doubleZ-dev/codex-keyboard/hardware/README.md

# 硬件资料

- [嘉立创 EDA 专业版工程](ProPrj_Codex_key_2026-10-20_10-08-15_2026-11-04.epro)
- [当前 BOM v0.96](Codex_Keyboard_开源BOM_v0.96.xlsx)：采购和最新材料参考成本以此为准。
- [早期成本表](Codex_Micro_整机成本_含3D打印件_2026-10-29.xlsx)：保留历史资料。

配套说明：[硬件与 GPIO](../docs/hardware.md) · [成本与采购](../docs/cost.md) · [图文装配](../docs/assembly.md)。

作者于 2026-11-02 确认黑色键帽 ¥0.60 是整套价格，BOM 中数量 1 按一套理解。原表中单颗表述的更正见[成本说明](../docs/cost.md)。

作者补充：主控板两层，厚度约 1.6 mm 待核对订单；灯板四层、1.6 mm。表面处理等制造信息尚待补充，采购、打样前请核对工程、BOM、固件接口与下单记录。
