doubleZ-dev/codex-keyboard/docs/images/front.jpg

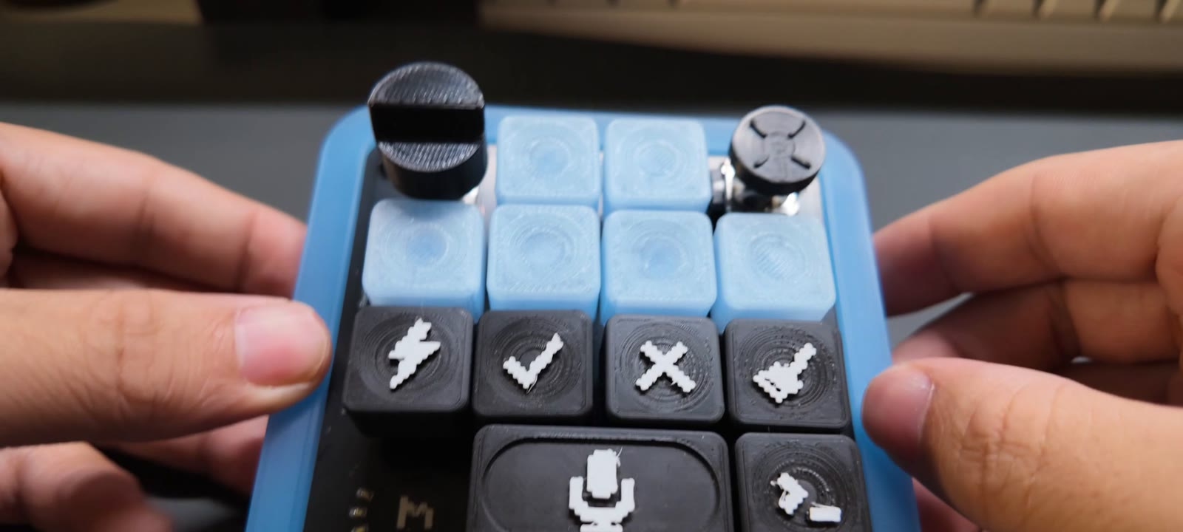
docs/images/front.jpg
