doubleZ-dev/codex-keyboard/hardware/Codex_Keyboard_开源BOM_v0.96.xlsx

Sheet: 成本总览
Codex Keyboard | 单机硬件成本
基于两份原始 BOM + 立创报价单 + 用户采购/3D 打印记录；价格以人民币计
成本分类 | 元件/装配单机成本 (¥) | 占总成本比例 | 来源 | 数量 / 时间
主控板元件 | ¥22.23 | 20.3% | 主控板原BOM | 29 类 / 48 件
灯板元件 | ¥45.60 | 41.7% | 灯板原BOM | 10 类 / 69 件
PCB | ¥21.00 | 19.2% | 电子器件合计 | 39 类 / 117 件
配套辅料 | ¥14.12 | 12.9% | 两份立创报价 | 2026-10-29
3D打印件 | ¥6.41 | 5.9% | 使用成本口径 | 单机实际装机
 |  |  | 价格更新 | 2026-11-01（采购规格更新）
整机材料成本 | ¥109.35 | 100.0% | 当前版本 | V0.96（电池容量850mAh）
统计口径：每台实际用量 × 采用单价；不按 MOQ/整包采购支出分摊，也不分摊立创整单折扣。
ESP32-S3 单价已由立创报价 ¥32.69 覆盖为用户淘宝实购价 ¥14.20；其他 38 种电子料沿用立创报价。
成本不包含：运费、焊接人工、贴片加工、设备折旧、试错损耗；如有其他未列配件需继续补充。
从“完整BOM”按板块筛选主控、灯板、PCB、辅料与打印件；绿色列是采用单价，蓝色列是行成本。

Sheet: 完整BOM
Codex Keyboard | Open-source Bill of Materials
V0.9 · 2026-11-01 · 单台实际用量核算 · 立创报价 2026-10-29 · ESP32-S3 采用淘宝实购价 ¥14.20
板块 | 物料分类 | 设计功能 | 原BOM序号 | 器件名称/Comment | 设计位号 | 每台数量 | BOM封装/Footprint | BOM数值/Value | 制造商型号/MPN | 制造商 | 立创物料编号 | 供应商 | 报价匹配状态 | 报价商品名称 | 报价匹配型号 | 报价品牌 | 报价封装 | 报价详细规格 | 商品链接 | 立创报价单价(¥) | 采用单价(¥) | 单机材料成本(¥) | MOQ | MPQ | 报价采购数量 | 报价采购小计(¥) | 供货渠道 | 交期 | 报价库存 | 价格来源 | 开源装配备注 | 资料状态 | 报价日期 | 原始报价文件 | 规格书链接 | 兼容替代型号
主控板元件 | 无源/电容 | 去耦、滤波或电源储能 | 1 | 100nF | C1,C2 | 2 | C0603 | 100nF | CC0603KRX7R9BB104 | YAGEO(国巨) | C14663 | LCSC | 系统匹配 | 100nF ±10% 50V | CC0603KRX7R9BB104 | YAGEO(国巨) | 0603 | 容值：100nF 精度：±10% 额定电压：50V 温度系数：X7R | https://item.szlcsc.com/15331.html | ¥0.0490 | ¥0.0490 | ¥0.0980 | 50 | 4000 | 50 | ¥2.45 | 现货 | 4小时内发货 | 42100 | 立创报价 2026-10-29 |  | 价格与型号齐全 | 2026-10-29 | 主控板立创报价.xls
主控板元件 | 无源/电容 | 去耦、滤波或电源储能 | 2 | 1uF | C7 | 1 | C0402 | 1uF | CL05A105KA5NQNC | SAMSUNG(三星) | C52923 | LCSC | 系统匹配 | 1uF ±10% 25V | CL05A105KA5NQNC | SAMSUNG(三星) | 0402 | 容值：1uF 精度：±10% 额定电压：25V 温度系数：X5R | https://item.szlcsc.com/53938.html | ¥0.0387 | ¥0.0387 | ¥0.0387 | 100 | 10000 | 100 | ¥3.87 | 现货 | 4小时内发货 | 2655500 | 立创报价 2026-10-29 |  | 价格与型号齐全 | 2026-10-29 | 主控板立创报价.xls
主控板元件 | 无源/电容 | 去耦、滤波或电源储能 | 3 | 22uF | C12,C13,C21 | 3 | C0603 | 22uF | CL10A226MP8NUNE | SAMSUNG(三星) | C86295 | LCSC | 系统匹配 | 22uF ±20% 10V | CL10A226MP8NUNE | SAMSUNG(三星) | 0603 | 容值：22uF 精度：±20% 额定电压：10V 温度系数：X5R | https://item.szlcsc.com/87471.html | ¥0.2004 | ¥0.2004 | ¥0.6012 | 10 | 3000 | 10 | ¥2.00 | 现货 | 4小时内发货 | 958720 | 立创报价 2026-10-29 |  | 价格与型号齐全 | 2026-10-29 | 主控板立创报价.xls
主控板元件 | 无源/电容 | 去耦、滤波或电源储能 | 4 | 100nF | C14,C15,C18,C19,C22,C25 | 6 | C0603 | 100nF | CL10B104KB8NNNC | SAMSUNG(三星) | C1591 | LCSC | 系统匹配 | 100nF ±10% 50V | CL10B104KB8NNNC | SAMSUNG(三星) | 0603 | 容值：100nF 精度：±10% 额定电压：50V 温度系数：X7R | https://item.szlcsc.com/1943.html | ¥0.0467 | ¥0.0467 | ¥0.2802 | 100 | 4000 | 100 | ¥4.67 | 现货 | 4小时内发货 | 51800 | 立创报价 2026-10-29 |  | 价格与型号齐全 | 2026-10-29 | 主控板立创报价.xls
主控板元件 | 无源/电容 | 去耦、滤波或电源储能 | 5 | 4.7uF | C16 | 1 | C0603 | 4.7uF | CL10A475KO8NNNC | SAMSUNG(三星) | C19666 | LCSC | 系统匹配 | 4.7uF ±10% 16V | CL10A475KO8NNNC | SAMSUNG(三星) | 0603 | 容值：4.7uF 精度：±10% 额定电压：16V 温度系数：X5R | https://item.szlcsc.com/20375.html | ¥0.1033 | ¥0.1033 | ¥0.1033 | 10 | 4000 | 10 | ¥1.03 | 现货 | 4小时内发货 | 525090 | 立创报价 2026-10-29 |  | 价格与型号齐全 | 2026-10-29 | 主控板立创报价.xls
主控板元件 | 无源/电容 | 去耦、滤波或电源储能 | 6 | 10uF | C17,C20 | 2 | C0603 | 10uF | CL10A106KP8NNNC | SAMSUNG(三星) | C19702 | LCSC | 系统匹配 | 10uF ±10% 10V | CL10A106KP8NNNC | SAMSUNG(三星) | 0603 | 容值：10uF 精度：±10% 额定电压：10V 温度系数：X5R | https://item.szlcsc.com/20411.html | ¥0.1290 | ¥0.1290 | ¥0.2580 | 20 | 4000 | 20 | ¥2.58 | 现货 | 4小时内发货 | 3186760 | 立创报价 2026-10-29 |  | 价格与型号齐全 | 2026-10-29 | 主控板立创报价.xls
主控板元件 | 电池/连接器 | 电池 1.25mm 双针连接器 | 7 | HC-1.25-2PLT | CN3 | 1 | CONN-SMD_HC-1.25-2PLT | 48 | HC-1.25-2PLT | HCTL(华灿天禄) | C2845388 | LCSC | 系统匹配 | 1x2P 间距:1.25mm 立贴 系列:PicoBlade(MX 1.25) | HC-1.25-2PLT | HCTL(华灿天禄) | SMD,P=1.25mm | 插针结构：1x2P 间距：1.25mm 安装方式：立贴 参考系列：PicoBlade(MX 1.25) 总PIN数：2P 排数：1 每排PIN数：2 行距：- 额定电流：2A 触头材质：黄铜 触头镀层：锡 工作温度：-25℃~+85℃ 额定电压：250V 塑料材质：LCP 阻燃等级：UL94V-0 附加特征：辅助焊脚 颜色：- Z轴-板上高度：4.75mm X轴-板上底边长度(间距线)：7.3mm Y轴-板上底边宽度：4.2mm | https://item.szlcsc.com/3039069.html | ¥0.3795 | ¥0.3795 | ¥0.3795 | 10 | 1500 | 10 | ¥3.80 | 现货 | 4小时内发货 | 101710 | 立创报价 2026-10-29 |  | 价格与型号齐全 | 2026-10-29 | 主控板立创报价.xls
主控板元件 | 电源/二极管 | 电源整流/隔离用肖特基二极管 | 8 | SS34 | D1,D3 | 2 | SMA_L4.2-W2.7-LS5.0-RD | 48 | SS34 | JSMSEMI(杰盛微) | C2837271 | LCSC | 系统匹配 | 电压:40V 电流:3A | SS34 | JSMSEMI(杰盛微) | SMA(DO-214AC) | 二极管配置：1个独立式 正向压降(Vf)：550mV@3A 直流反向耐压(Vr)：40V 整流电流：3A 反向电流(Ir)：- 工作结温范围：-50℃~+125℃ 非重复峰值浪涌电流 (Ifsm)：100A 耗散功率(Pd)：- | https://item.szlcsc.com/3007843.html | ¥0.1543 | ¥0.1543 | ¥0.3086 | 20 | 2000 | 20 | ¥3.09 | 现货 | 4小时内发货 | 545920 | 立创报价 2026-10-29 |  | 价格与型号齐全 | 2026-10-29 | 主控板立创报价.xls
主控板元件 | USB/保护 | USB D+/D− ESD 保护 | 9 | H5VL10B | D2,D4 | 2 | SOD-882_L1.0-W0.6-BI | 48 | H5VL10B | R+O(宏嘉诚) | C7420372 | LCSC | 系统匹配 | 丝印 PB 双向ESD 5V截止 峰值浪涌电流：5A | H5VL10B | R+O(宏嘉诚) | DFN1006-2L | 极性：双向 反向工作电压(Vrwm)：5V 钳位电压：10V 峰值脉冲电流(Ipp)：5A 峰值脉冲功率(Ppp)：50W 击穿电压(VBR)：5.6V 反向漏电流(Ir)：100nA 通道数：单路 工作温度：-55℃~+125℃ 防护等级：IEC 61000-4-2；IEC 61000-4-5 类型：ESD Cj-结电容：15pF 丝印 PB | https://item.szlcsc.com/8397194.html | ¥0.0371 | ¥0.0371 | ¥0.0743 | 50 | 10000 | 50 | ¥1.86 | 现货 | 4小时内发货 | 5237750 | 立创报价 2026-10-29 |  | 价格与型号齐全 | 2026-10-29 | 主控板立创报价.xls
主控板元件 | 板间连接 | 双板 30Pin、0.5mm FPC/FFC 接口 | 10 | FPC-05F-30PH20 | FPC2 | 1 | FPC-SMD_30P-P0.50_XUNPU_FPC-05F-30PH20 | 48 | FPC-05F-30PH20 | XUNPU(讯普) | C2856808 | LCSC | 系统匹配 | 翻盖式 下接 P数:30P 间距:0.5mm | FPC-05F-30PH20 | XUNPU(讯普) | SMD,P=0.5mm,卧贴 | 锁定特性：翻盖式 触点类型：下接 触点数量：30P 间距：0.5mm 安装方式：卧贴 接入柔性电缆厚度：0.3mm 板上高度：2mm 触头材质：磷青铜 触头镀层：锡 工作温度：-25℃~+85℃ 额定电压：50V 额定电流：500mA | https://item.szlcsc.com/3056906.html | ¥0.8728 | ¥0.8728 | ¥0.8728 | 5 | 2000 | 5 | ¥4.36 | 现货 | 4小时内发货 | 49585 | 立创报价 2026-10-29 |  | 价格与型号齐全 | 2026-10-29 | 主控板立创报价.xls
主控板元件 | 无源/电感 | 开关电源储能 | 11 | 4.7uH | L1 | 1 | IND-SMD_L4.0-W4.0_LVS404018 | 4.7uH | PNR4020-4R7-M | JIERR(捷而瑞) | C55381750 | LCSC | 系统匹配 | 4.7uH±20% 2.5A | PNR4020-4R7-M | JIERR(捷而瑞) | SMD,4x4mm | 电感值：4.7uH 精度：±20% 额定电流：2A 饱和电流(Isat)：2.5A 直流电阻(DCR)：75mΩ 类型：磁胶屏蔽电感 | https://item.szlcsc.com/59339378.html | ¥0.3755 | ¥0.3755 | ¥0.3755 | 10 | 3000 | 10 | ¥3.76 | 现货 | 4小时内发货 | 6270 | 立创报价 2026-10-29 |  | 价格与型号齐全 | 2026-10-29 | 主控板立创报价.xls
主控板元件 | 电源/切换 | P沟道MOS电源切换/开关 | 12 | AO3401A | Q1,Q2 | 2 | SOT-23_L2.9-W1.3-P1.90-LS2.4-BR | 48 | AO3401A | UMW(友台半导体) | C347476 | LCSC | 系统匹配 | 1个P沟道 耐压:30V 电流:4.2A | AO3401A | UMW(友台半导体) | SOT-23 | 数量：1个P沟道 漏源电压(Vdss)：30V 连续漏极电流(Id)：4.2A 导通电阻(RDS(on))：50mΩ@10V 耗散功率(Pd)：1.4W 阈值电压(Vgs(th))：1.3V 栅极电荷量(Qg)：9.4nC@4.5V 输入电容(Ciss)：954pF 反向传输电容(Crss)：77pF 工作温度：-55℃~+150℃ 类型：P沟道 输出电容(Coss)：115pF | https://item.szlcsc.com/324136.html | ¥0.1941 | ¥0.1941 | ¥0.3882 | 20 | 3000 | 20 | ¥3.88 | 现货 | 4小时内发货 | 1089980 | 立创报价 2026-10-29 |  | 价格与型号齐全 | 2026-10-29 | 主控板立创报价.xls
主控板元件 | 无源/电阻 | 上拉、限流、分压或反馈 | 13 | 10kΩ | R1,R2 | 2 | R0402 | 10kΩ | 0402WGF1002TCE | UNI-ROYAL(厚声) | C25744 | LCSC | 系统匹配 | 厚膜电阻 10kΩ ±1% 62.5mW | 0402WGF1002TCE | UNI-ROYAL(厚声) | 0402 | 电阻类型：厚膜电阻 阻值：10kΩ 精度：±1% 功率：62.5mW 工作电压：50V 温度系数：±100ppm/℃ 工作温度：-55℃~+155℃ | https://item.szlcsc.com/26487.html | ¥0.0142 | ¥0.0142 | ¥0.0284 | 100 | 10000 | 100 | ¥1.42 | 订货 | 预估7-10个工作日 | 0 | 立创报价 2026-10-29 |  | 价格与型号齐全 | 2026-10-29 | 主控板立创报价.xls
主控板元件 | 无源/电阻 | 上拉、限流、分压或反馈 | 14 | 510Ω | R3 | 1 | R0402 | 510Ω | FRC0402F5100TS | FOJAN(富捷) | C2909366 | LCSC | 系统匹配 | 厚膜电阻 510Ω ±1% 62.5mW | FRC0402F5100TS | FOJAN(富捷) | 0402 | 电阻类型：厚膜电阻 阻值：510Ω 精度：±1% 功率：62.5mW 工作电压：50V 温度系数：±100ppm/℃ 工作温度：-55℃~+155℃ | https://item.szlcsc.com/3186301.html | ¥0.0091 | ¥0.0091 | ¥0.0091 | 100 | 10000 | 100 | ¥0.91 | 现货 | 4小时内发货 | 2088400 | 立创报价 2026-10-29 |  | 价格与型号齐全 | 2026-10-29 | 主控板立创报价.xls
主控板元件 | 无源/电阻 | 上拉、限流、分压或反馈 | 15 | 22Ω | R4,R8 | 2 | R0402 | 22Ω | FRC0402F22R0TS | FOJAN(富捷) | C2929994 | LCSC | 系统匹配 | 厚膜电阻 22Ω ±1% 62.5mW | FRC0402F22R0TS | FOJAN(富捷) | 0402 | 电阻类型：厚膜电阻 阻值：22Ω 精度：±1% 功率：62.5mW 工作电压：50V 温度系数：±100ppm/℃ 工作温度：-55℃~+155℃ | https://item.szlcsc.com/3266927.html | ¥0.0095 | ¥0.0095 | ¥0.0190 | 100 | 10000 | 100 | ¥0.95 | 现货 | 4小时内发货 | 3976000 | 立创报价 2026-10-29 |  | 价格与型号齐全 | 2026-10-29 | 主控板立创报价.xls
主控板元件 | 无源/电阻 | 上拉、限流、分压或反馈 | 16 | 110kΩ | R5 | 1 | R0603 | 110kΩ | FRC0603F1103TS | FOJAN(富捷) | C2906984 | LCSC | 系统匹配 | 厚膜电阻 110kΩ ±1% 100mW | FRC0603F1103TS | FOJAN(富捷) | 0603 | 电阻类型：厚膜电阻 阻值：110kΩ 精度：±1% 功率：100mW 工作电压：75V 温度系数：±100ppm/℃ 工作温度：-55℃~+155℃ | https://item.szlcsc.com/3180497.html | ¥0.0113 | ¥0.0113 | ¥0.0113 | 100 | 5000 | 100 | ¥1.13 | 现货 | 4小时内发货 | 223400 | 立创报价 2026-10-29 |  | 价格与型号齐全 | 2026-10-29 | 主控板立创报价.xls
主控板元件 | 无源/电阻 | 上拉、限流、分压或反馈 | 17 | 15kΩ | R7 | 1 | R0603 | 15kΩ | FRC0603F1502TS | FOJAN(富捷) | C2906995 | LCSC | 系统匹配 | 厚膜电阻 15kΩ ±1% 100mW | FRC0603F1502TS | FOJAN(富捷) | 0603 | 电阻类型：厚膜电阻 阻值：15kΩ 精度：±1% 功率：100mW 工作电压：75V 温度系数：±100ppm/℃ 工作温度：-55℃~+155℃ | https://item.szlcsc.com/3180508.html | ¥0.0114 | ¥0.0114 | ¥0.0114 | 100 | 5000 | 100 | ¥1.14 | 现货 | 4小时内发货 | 4299300 | 立创报价 2026-10-29 |  | 价格与型号齐全 | 2026-10-29 | 主控板立创报价.xls
主控板元件 | 无源/电阻 | 上拉、限流、分压或反馈 | 18 | 5.1kΩ | R10,R11 | 2 | R0603 | 5.1kΩ | 0603WAF5101T5E | UNI-ROYAL(厚声) | C23186 | LCSC | 系统匹配 | 厚膜电阻 5.1kΩ ±1% 100mW | 0603WAF5101T5E | UNI-ROYAL(厚声) | 0603 | 电阻类型：厚膜电阻 阻值：5.1kΩ 精度：±1% 功率：100mW 工作电压：75V 温度系数：±100ppm/℃ 工作温度：-55℃~+155℃ | https://item.szlcsc.com/23913.html | ¥0.0091 | ¥0.0091 | ¥0.0182 | 100 | 5000 | 100 | ¥0.91 | 现货 | 4小时内发货 | 16407800 | 立创报价 2026-10-29 |  | 价格与型号齐全 | 2026-10-29 | 主控板立创报价.xls
主控板元件 | 无源/电阻 | 上拉、限流、分压或反馈 | 19 | 10kΩ | R13,R14 | 2 | R0603 | 10kΩ | FRC0603J103 TS | FOJAN(富捷) | C2930027 | LCSC | 系统匹配 | 厚膜电阻 10kΩ ±5% 100mW | FRC0603J103 TS | FOJAN(富捷) | 0603 | 电阻类型：厚膜电阻 阻值：10kΩ 精度：±5% 功率：100mW 工作电压：75V 温度系数：±100ppm/℃ 工作温度：-55℃~+155℃ | https://item.szlcsc.com/3266960.html | ¥0.0100 | ¥0.0100 | ¥0.0199 | 100 | 5000 | 100 | ¥1.00 | 现货 | 4小时内发货 | 6377900 | 立创报价 2026-10-29 |  | 价格与型号齐全 | 2026-10-29 | 主控板立创报价.xls
主控板元件 | 无源/电阻 | 上拉、限流、分压或反馈 | 20 | 100kΩ | R20,R23 | 2 | R0603 | 100kΩ | FRC0603J104 TS | FOJAN(富捷) | C2907088 | LCSC | 系统匹配 | 厚膜电阻 100kΩ ±5% 100mW | FRC0603J104 TS | FOJAN(富捷) | 0603 | 电阻类型：厚膜电阻 阻值：100kΩ 精度：±5% 功率：100mW 工作电压：75V 温度系数：±100ppm/℃ 工作温度：-55℃~+155℃ | https://item.szlcsc.com/3180601.html | ¥0.0064 | ¥0.0064 | ¥0.0127 | 100 | 5000 | 100 | ¥0.64 | 现货 | 4小时内发货 | 5341700 | 立创报价 2026-10-29 |  | 价格与型号齐全 | 2026-10-29 | 主控板立创报价.xls
主控板元件 | 无源/电阻 | 上拉、限流、分压或反馈 | 21 | 2kΩ | R25 | 1 | R0603 | 2kΩ | FRC0603J202 TS | FOJAN(富捷) | C2907137 | LCSC | 系统匹配 | 厚膜电阻 2kΩ ±5% 100mW | FRC0603J202 TS | FOJAN(富捷) | 0603 | 电阻类型：厚膜电阻 阻值：2kΩ 精度：±5% 功率：100mW 工作电压：75V 温度系数：±100ppm/℃ 工作温度：-55℃~+155℃ | https://item.szlcsc.com/3180650.html | ¥0.0076 | ¥0.0076 | ¥0.0076 | 100 | 5000 | 100 | ¥0.76 | 现货 | 4小时内发货 | 3773800 | 立创报价 2026-10-29 |  | 价格与型号齐全 | 2026-10-29 | 主控板立创报价.xls
主控板元件 | 电源/开关 | 侧拨电源滑动开关 | 22 | SS-205-AGS7P-150 | SW1 | 1 | SW-SMD_SS-205-AGS7P-150 | 48 | SS-205-AGS7P-150 | XUNPU(讯普) | C42377849 | LCSC | 系统匹配 | 卧式侧拨迷你七脚 贴片滑动开关 二档微型拨动开关 柄高1.5mm | SS-205-AGS7P-150 | XUNPU(讯普) | SMD-7P,5x1.4mm | 电路结构：单刀双掷 滑钮形状：矩形柱状 引脚样式：SMD接片 开关长度：5mm 开关宽度：1.4mm 开关高度：4.25mm 安装方式：卧贴 开关颜色：黑色 额定电流：50mA 额定电压：12V 工作寿命：1万次 操作力：150gf 触头镀层：银 行程长度：1.2mm 工作温度：-30℃~+85℃ | https://item.szlcsc.com/44278016.html | ¥0.7303 | ¥0.7303 | ¥0.7303 | 5 | 4000 | 5 | ¥3.65 | 现货 | 4小时内发货 | 4910 | 立创报价 2026-10-29 |  | 价格与型号齐全 | 2026-10-29 | 主控板立创报价.xls
主控板元件 | 控制/按键 | BOOT/RESET 功能按键 | 23 | ZX-QC34-2TPDZ | SW2,SW3 | 2 | KEY-SMD_L3.9-W3.0-LS5.0-EH | 48 | ZX-QC34-2TPDZ | Megastar(兆星) | C7470219 | LCSC | 系统匹配 | 3*4*2贴片开关带柱 | ZX-QC34-2TPDZ | Megastar(兆星) | SMD,4x3mm | 电路结构：单刀单掷 按钮形状：圆形按钮 作用力：2.6N 安装方式：立贴 开关长度：3mm 开关宽度：4mm 开关高度：2mm 带支架：不带支架 触点电流：50mA 额定电压：12V 按钮/盖帽颜色：黑色 引脚样式：鸥翼型 工作寿命：10万次 工作温度：-30℃~+80℃ | https://item.szlcsc.com/8519225.html | ¥0.2023 | ¥0.2023 | ¥0.4045 | 10 | 3000 | 10 | ¥2.02 | 现货 | 4小时内发货 | 24490 | 立创报价 2026-10-29 |  | 价格与型号齐全 | 2026-10-29 | 主控板立创报价.xls
主控板元件 | 数字逻辑 | 两条 RGB 数据链的 3.3V→5V 缓冲 | 24 | SN74AHCT1G125DBVR | U1,U2 | 2 | SOT-23-5_L3.0-W1.7-P0.95-LS2.8-BR | 48 | SN74AHCT1G125DBVR | TI(德州仪器) | C7484 | LCSC | 系统匹配 | 三态输出，单路总线缓冲门 | SN74AHCT1G125DBVR | TI(德州仪器) | SOT-23-5 | 输入类型：- 输出类型：三态 工作电压：4.5V~5.5V 元件数：1 每个元件位数：1 通道类型：单向 灌电流(IOL)：8mA 拉电流(IOH)：8mA 系列：74AHCT 工作温度：-40℃~+125℃ 静态电流(Iq)：10uA 传播延迟(tpd)：6.5ns@5V,15pF 功能特性：输出使能 | https://item.szlcsc.com/7961.html | ¥0.6131 | ¥0.6131 | ¥1.2262 | 5 | 3000 | 5 | ¥3.07 | 现货 | 4小时内发货 | 12540 | 立创报价 2026-10-29 |  | 价格与型号齐全 | 2026-10-29 | 主控板立创报价.xls
主控板元件 | 电源/升压 | 单节电池至 5V 升压 | 25 | MT3608B | U3 | 1 | SOT-23-6_L2.9-W1.6-P0.95-LS2.8-BR | 48 | MT3608B | 西安航天民芯 | C19189893 | LCSC | 系统匹配 | 升压型 4A 2.5V~24V 停产 | MT3608B | 西安航天民芯 | SOT-23-6 | 功能类型：升压型 工作电压：2.5V~24V 输出电压：- 输出电流：4A 开关频率：1.2MHz 工作温度：-40℃~+85℃ 同步整流：否 输出通道数：1 拓扑结构：升压式 静态电流(Iq)：70uA 开关管(内置/外置)：内置 输出类型：可调 功能特性：轻载高效模式；过流保护 | https://item.szlcsc.com/20421435.html | ¥0.6382 | ¥0.6382 | ¥0.6382 | 10 | 3000 | 10 | ¥6.38 | 现货 | 4小时内发货 | 85460 | 立创报价 2026-10-29 |  | 价格与型号齐全 | 2026-10-29 | 主控板立创报价.xls
主控板元件 | 电源/充电 | 单节锂电池 USB 充电 | 26 | TP4057 | U4 | 1 | SOT-23-6_L2.9-W1.6-P0.95-LS2.8-BL | 48 | TP4057 | TPOWER(天源) | C440390 | LCSC | 系统匹配 | 0.6A锂电池充电IC | TP4057 | TPOWER(天源) | SOT-23-6 | 芯片类型：充电芯片 工作电压：4.5V~5.5V 最大充电电流：600mA 充电饱和电压：4.2V 放电截止电压：- 电池类型：锂电池 电池节数：1 工作温度：-40℃~+85℃ 电池温度检测：不支持 0V电池充电：不支持 静态电流(Iq)：3uA 均衡电流：- 接口类型：- 功能特性：恒压充电；恒流充电；自动再充电；充电终止；软启动；可编程充电电流；欠压锁定；涓流充电 | https://item.szlcsc.com/439837.html | ¥0.4685 | ¥0.4685 | ¥0.4685 | 10 | 3000 | 10 | ¥4.69 | 现货 | 4小时内发货 | 4460 | 立创报价 2026-10-29 |  | 价格与型号齐全 | 2026-10-29 | 主控板立创报价.xls
主控板元件 | 电源/稳压 | 5V 降至 3.3V 供电 | 27 | AMS1117-3.3 | U5 | 1 | SOT-223-3_L6.7-W3.7-P2.30-LS7.0-BR | 48 | AMS1117-3.3 | GR(国睿) | C18164485 | LCSC | 系统匹配 | 3.3V 1A 15V | AMS1117-3.3 | GR(国睿) | SOT-223 | 输出极性：正极 工作电压：15V 输出电压：3.3V 输出电流：1A 电源纹波抑制比(PSRR)：75dB@(120Hz) 压差：1.2V@(1A) 静态电流(Iq)：5mA 噪声：0.003%Vout 功能特性：热关断；过流保护 工作温度：0℃~+150℃@(Tj) 输出类型：固定 输出通道数：1 | https://item.szlcsc.com/19305548.html | ¥0.2423 | ¥0.2423 | ¥0.2423 | 20 | 2500 | 20 | ¥4.85 | 现货 | 4小时内发货 | 36000 | 立创报价 2026-10-29 |  | 价格与型号齐全 | 2026-10-29 | 主控板立创报价.xls
主控板元件 | 主控/通信 | ESP32-S3 主控模组（USB HID/CDC、BLE、输入与灯光控制） | 28 | ESP32-S3-WROOM-1-N16R8 | U8 | 1 | WIRELM-SMD_ESP32-S3-WROOM-1 | 48 | ESP32-S3-WROOM-1-N16R8 | ESPRESSIF(乐鑫) | C2913202 | LCSC | 系统匹配 | 不带固件 通用型Wi-Fi+低功耗蓝牙MCU模组 | ESP32-S3-WROOM-1-N16R8 | ESPRESSIF(乐鑫) | SMD,25.5x18mm | 核心芯片：ESP32-S3R8 接口类型：I2C；GPIO；UART；SPI；USB；I2S 频率：2.4GHz 天线形式：板载PCB天线 发射功率：20.5dBm 工作电压：3V~3.6V 接收电流：95mA 发送电流：355mA 接收灵敏度：-103.5dBm 工作温度：-40℃~+65℃ 不带固件 | https://item.szlcsc.com/3198300.html | ¥32.6900 | ¥14.2000 | ¥14.2000 | 1 | 650 | 1 | ¥32.69 | 现货 | 4小时内发货 | 31338 | 淘宝实购 ¥14.20 | 以用户确认的实际单价覆盖立创报价 | 价格与型号齐全 | 2026-10-29 | 主控板立创报价.xls
主控板元件 | USB/连接器 | USB Type-C 数据与供电接口 | 29 | TYPE-C16PIN | USB1 | 1 | USB-C-SMD_TYPE-C16PIN | 48 | TYPE-C16PIN | SHOU HAN(首韩) | C393939 | LCSC | 系统匹配 | Type-C 母 卧贴 | TYPE-C16PIN | SHOU HAN(首韩) | SMD | 连接器类型：Type-C 协议标准：- 公母：母 安装方式：卧贴 触点数量：16P 端口数量：1 额定电流 - 电源：3A 额定电压：5V 插拔寿命：1万次 附加特征：- 中心高度(CH)：- 体长(L)：7.35mm 胶芯颜色：黑色 工作温度：-25℃~+85℃ | https://item.szlcsc.com/372551.html | ¥0.4007 | ¥0.4007 | ¥0.4007 | 10 | 1000 | 10 | ¥4.01 | 现货 | 4小时内发货 | 399000 | 立创报价 2026-10-29 |  | 价格与型号齐全 | 2026-10-29 | 主控板立创报价.xls
灯板元件 | 无源/电容 | 去耦、滤波或电源储能 | 1 | 100nF | C1,C2,C3,C4,C5,C6,C7,C8,C9,C10,C11,C12,C13 | 13 | C0603 | 100nF | CC0603KRX7R9BB104 | YAGEO(国巨) | C14663 | LCSC | 系统匹配 | 100nF ±10% 50V | CC0603KRX7R9BB104 | YAGEO(国巨) | 0603 | 容值：100nF 精度：±10% 额定电压：50V 温度系数：X7R | https://item.szlcsc.com/15331.html | ¥0.0490 | ¥0.0490 | ¥0.6370 | 50 | 4000 | 50 | ¥2.45 | 现货 | 4小时内发货 | 42100 | 立创报价 2026-10-29 |  | 价格与型号齐全 | 2026-10-29 | 灯板立创报价.xls
灯板元件 | 键盘/隔离二极管 | 矩阵逐键隔离、防鬼键 | 2 | 1N4148W-7-F | D1,D2,D3,D4,D5,D6,D7,D8,D9,D10,D11,D12,D13 | 13 | SOD-123_L2.7-W1.6-LS3.7-RD-1 | 22 | 1N4148W-7-F | DIODES(美台) | C83528 | LCSC | 系统匹配 | 100V 300mA | 1N4148W-7-F | DIODES(美台) | SOD-123 | 二极管配置：独立式 耗散功率(Pd)：400mW 整流电流：300mA 直流反向耐压(Vr)：100V 正向压降(Vf)：1.25V@150mA 非重复峰值浪涌电流 (Ifsm)：2A 反向电流(Ir)：1uA@75V 反向恢复时间(Trr)：4ns 工作结温范围：-65℃~+150℃ | https://item.szlcsc.com/84693.html | ¥0.1629 | ¥0.1629 | ¥2.1177 | 20 | 3000 | 20 | ¥3.26 | 现货 | 4小时内发货 | 5340 | 立创报价 2026-10-29 |  | 价格与型号齐全 | 2026-10-29 | 灯板立创报价.xls
灯板元件 | 板间连接 | 双板 30Pin、0.5mm FPC/FFC 接口 | 3 | FPC-05F-30PH20 | FPC2 | 1 | FPC-SMD_30P-P0.50_XUNPU_FPC-05F-30PH20 | 22 | FPC-05F-30PH20 | XUNPU(讯普) | C2856808 | LCSC | 系统匹配 | 翻盖式 下接 P数:30P 间距:0.5mm | FPC-05F-30PH20 | XUNPU(讯普) | SMD,P=0.5mm,卧贴 | 锁定特性：翻盖式 触点类型：下接 触点数量：30P 间距：0.5mm 安装方式：卧贴 接入柔性电缆厚度：0.3mm 板上高度：2mm 触头材质：磷青铜 触头镀层：锡 工作温度：-25℃~+85℃ 额定电压：50V 额定电流：500mA | https://item.szlcsc.com/3056906.html | ¥0.8728 | ¥0.8728 | ¥0.8728 | 5 | 2000 | 5 | ¥4.36 | 现货 | 4小时内发货 | 49585 | 立创报价 2026-10-29 |  | 价格与型号齐全 | 2026-10-29 | 灯板立创报价.xls
灯板元件 | 灯光/按键RGB | 13颗可寻址 RGB 按键背光 | 4 | SK6812MINI-E | LED1,LED2,LED3,LED4,LED5,LED6,LED7,LED8,LED9,LED10,LED11,LED12,LED13 | 13 | LED-SMD_4P-L3.2-W2.8-LS5.9_SK6812MINI-E | 22 | SK6812MINI-E | OPSCO(欧思科) | C5149201 | LCSC | 系统匹配 | 工作电压5V、发光角度120°、灰度调节256级的RGB LED | SK6812MINI-E | OPSCO(欧思科) | SMD | 主波长-红：620nm~625nm 主波长-绿：515nm~525nm 主波长-蓝：460nm~470nm 数据速率：800Kbit/s 工作电压：3.7V~5.5V 静态电流：0.6mA 透镜颜色：半透明透镜 抗静电能力：2000V 载带方式：- 工作温度：-40℃~+85℃ PWM频率：1kHz 灯头类型：- 发光角度：120° 长度：3.2mm 宽度：1.78mm 高度：2.8mm 脚间距：- 功能特性：- 峰值波长-红：- 峰值波长-绿：- 峰值波长-蓝：- 发光强度-红：160mcd~320mcd 发光强度-绿：815mcd~1275mcd 发光强度-蓝：120mcd~240mcd 传输延迟：- 上升时间：- 下降时间：- | https://item.szlcsc.com/5773397.html | ¥0.4923 | ¥0.4923 | ¥6.3999 | 5 | 2000 | 15 | ¥7.38 | 现货 | 4小时内发货 | 105325 | 立创报价 2026-10-29 |  | 价格与型号齐全 | 2026-10-29 | 灯板立创报价.xls
灯板元件 | 无源/电阻 | 上拉、限流、分压或反馈 | 5 | 1kΩ | R1,R2,R5 | 3 | R0402 | 1kΩ | 0402WGF1001TCE | UNI-ROYAL(厚声) | C11702 | LCSC | 系统匹配 | 厚膜电阻 1kΩ ±1% 62.5mW | 0402WGF1001TCE | UNI-ROYAL(厚声) | 0402 | 电阻类型：厚膜电阻 阻值：1kΩ 精度：±1% 功率：62.5mW 工作电压：50V 温度系数：±100ppm/℃ 工作温度：-55℃~+155℃ | https://item.szlcsc.com/12256.html | ¥0.0077 | ¥0.0077 | ¥0.0231 | 100 | 10000 | 100 | ¥0.77 | 现货 | 4小时内发货 | 11361900 | 立创报价 2026-10-29 |  | 价格与型号齐全 | 2026-10-29 | 灯板立创报价.xls
灯板元件 | 控制/编码器 | 旋转编码器及按压 | 6 | EC11E18244A5 | SW1 | 1 | SW-TH_EC11E18244A5 | 22 | EC11E18244A5 | ALPSALPINE(阿尔卑斯阿尔派) | C255515 | LCSC | 系统匹配 | 11mm尺寸金属轴类型 | EC11E18244A5 | ALPSALPINE(阿尔卑斯阿尔派) | 插件 | 编码器类型：增量式 节点数/脉冲数(增量式)：36/18 输出形式：两相输出 是否可下按：支持 转轴复位：自复位 安装方式：直插 额定电流：10mA 额定电压：5V 工作温度：-40℃~+85℃ | https://item.szlcsc.com/249470.html | ¥14.7800 | ¥14.7800 | ¥14.7800 | 1 | 120 | 1 | ¥14.78 | 现货 | 4小时内发货 | 262 | 立创报价 2026-10-29 |  | 价格与型号齐全 | 2026-10-29 | 灯板立创报价.xls
灯板元件 | 键盘/机械开关 | 13 键机械输入，4×4矩阵 | 7 | CPG151101D13 | U1,U4,U5,U7,U14,U15,U16,U17,U18,U19,U20,U21,U22 | 13 | KEY-TH_CPG151101D21X | 22 | CPG151101D13 | HanElectricity(瀚源) | C49234235 | LCSC | 系统匹配 | 青轴 | CPG151101D13 | HanElectricity(瀚源) | 插件 | 轴类型：青轴 作用力：50gf 触发行程：2.2mm 额定电压：12V 工作温度：-40℃~+70℃ | https://item.szlcsc.com/51650377.html | ¥0.6242 | ¥0.6242 | ¥8.1152 | 5 | 500 | 15 | ¥9.36 | 现货 | 4小时内发货 | 10130 | 立创报价 2026-10-29 |  | 价格与型号齐全 | 2026-10-29 | 灯板立创报价.xls
灯板元件 | 灯光/氛围RGB | 8颗可寻址 RGB 氛围灯 | 8 | WS2812B-4020-V6 | U2,U3,U6,U8,U9,U10,U11,U12 | 8 | LED-SMD_4P-L4.0-W1.7_DCS-CA4020A0R02G02B02CE004 | 22 | WS2812B-4020-V6 | worldsemi | C52941387 | LCSC | 系统匹配 | 智能外控集成LED光源，控制电路与RGB芯片集成，内置信号整形和复位电路，支持单线归零码通讯，光颜色高度一致 | WS2812B-4020-V6 | worldsemi | SMD-4P,4x2mm | 主波长-红：620nm~625nm 主波长-绿：515nm~525nm 主波长-蓝：465nm~475nm 数据速率：800Kbit/s 工作电压：3.3V~5.3V 静态电流：1uA 透镜颜色：- 抗静电能力：- 载带方式：- 工作温度：-40℃~+85℃ PWM频率：2kHz 灯头类型：- 发光角度：- 长度：3.98mm 宽度：2mm 高度：1.7mm 脚间距：- 功能特性：内置上电复位电路；集成智能反向连接保护功能；内置掉电复位电路 峰值波长-红：- 峰值波长-绿：- 峰值波长-蓝：- 发光强度-红：300mcd~500mcd 发光强度-绿：600mcd~1000mcd 发光强度-蓝：200mcd~300mcd 传输延迟：300ns 上升时间：- 下降时间：120us | https://item.szlcsc.com/55856750.html | ¥0.6416 | ¥0.6416 | ¥5.1328 | 5 | 2000 | 10 | ¥6.42 | 现货 | 4小时内发货 | 1090 | 立创报价 2026-10-29 |  | 价格与型号齐全 | 2026-10-29 | 灯板立创报价.xls
灯板元件 | 灯光/状态LED | 三颗图层/蓝牙状态指示灯 | 9 | XL-1005UWC | U13,U23,U24 | 3 | LED0402-RD_YELLOW | 22 | XL-1005UWC | XINGLIGHT(成兴光) | C20613596 | LCSC | 系统匹配 | 0402冷白光贴片式发光二极管 | XL-1005UWC | XINGLIGHT(成兴光) | 0402 | 灯头类型：1mmx0.5mm方形灯头 发光颜色：白色 正向压降(Vf)：2.8V 功率：75mW 测试电流：5mA 波长：- 峰值波长：- 二极管配置：独立二极管 透镜颜色：黄色透镜 色温：15000K 发光强度：1cd 发光角度：120° 载带方式：正贴 工作温度：-40℃~+85℃ 抗静电能力：2000V | https://item.szlcsc.com/21979587.html | ¥0.0657 | ¥0.0657 | ¥0.1972 | 50 | 5000 | 50 | ¥3.29 | 现货 | 4小时内发货 | 90050 | 立创报价 2026-10-29 |  | 价格与型号齐全 | 2026-10-29 | 灯板立创报价.xls
灯板元件 | 控制/摇杆 | 双轴模拟摇杆及按压 | 10 | 10kΩ | VR1 | 1 | SW-TH_RKJXV1224005 | 10kΩ | RKJXV122400R | ALPSALPINE(阿尔卑斯阿尔派) | C918854 | LCSC | 系统匹配 | 10kΩ ±5% | RKJXV122400R | ALPSALPINE(阿尔卑斯阿尔派) | 插件 | 阻值：10kΩ 精度：±5% 额定电压：5V 功率：125mW 圈数：- | https://item.szlcsc.com/995767.html | ¥7.3200 | ¥7.3200 | ¥7.3200 | 1 | 142 | 1 | ¥7.32 | 现货 | 4小时内发货 | 4794 | 立创报价 2026-10-29 |  | 价格与型号齐全 | 2026-10-29 | 灯板立创报价.xls
PCB | PCB/主控板 | 主控板裸板加工 |  | 主控板 PCB |  | 1 |  |  |  |  |  |  |  |  |  |  |  |  |  |  | ¥3.0000 | ¥3.0000 |  |  |  |  |  |  |  | 用户提供价格 | PCB 生产单价每片 ¥3；层数、厚度、表面处理可补 | 需补制造参数 | 2026-10-29 | 用户采购与打印记录
PCB | PCB/灯板 | 键盘灯板裸板加工 |  | 灯板 PCB |  | 1 |  |  |  |  |  |  |  |  |  |  |  |  |  |  | ¥18.0000 | ¥18.0000 |  |  |  |  |  |  |  | 用户提供价格 | PCB 生产单价每片 ¥18；层数、厚度、阻焊颜色可补 | 需补制造参数 | 2026-10-29 | 用户采购与打印记录
配套辅料 | 锂电池 | 单节锂电池供电 |  | 3.7V 850mAh 锂电池（订单选项 603443） |  | 1 |  | 3.7V / 850mAh / 603443 | 603443（商家选项） |  |  | 淘宝商家（订单截图） |  |  |  |  |  |  |  |  | ¥8.5000 | ¥8.5000 |  |  |  |  |  |  |  | 用户订单截图 + 已提供采购价格 | 3.7V 单节锂电池，额定容量 850mAh，订单选项 603443；保护板参数、线束极性仍按商家资料及实物核对。采购价 ¥8.50/个。 | 电压/容量/订单选项已补 | 2026-11-01 | 用户2026-11-01电池订单截图及容量补充
配套辅料 | 紧固件 | 热熔嵌入式固定 |  | M3 热熔螺母 M3×4×4.5 |  | 8 |  | M3×4×4.5mm | M3×4×4.5 |  |  | 淘宝商家（订单截图） |  |  |  |  |  |  |  |  | ¥0.0975 | ¥0.7800 | 40 |  | 40 | ¥3.90 |  |  |  | 用户订单截图 + 已提供采购价格 | 注塑热熔铜螺母；订单选项 M3×4×4.5，40只/包¥3.90；每台装8只。详细外形以商品尺寸图为准。 | 采购规格已补 | 2026-11-01 | 用户2026-11-01螺母订单截图
配套辅料 | 紧固件 | PCB/壳体装配 |  | M3×6 内六角圆柱头螺钉 |  | 8 |  | M3×6mm | M3×6 |  |  | 淘宝商家（订单截图） |  |  |  |  |  |  |  |  | ¥0.0520 | ¥0.4160 | 50 |  | 50 | ¥2.60 |  |  |  | 用户订单截图 + 已提供采购价格 | 商品描述：内六角圆柱头/杯头螺丝、12.9级高强度；订单 M3×6（50个）¥2.60；每台装8只。 | 采购规格已补 | 2026-11-01 | 用户2026-11-01螺丝订单截图
配套辅料 | 音频模块 | 数字麦克风输入 |  | INMP441 MEMS 数字麦克风模块 |  | 1 |  | I2S / MEMS | INMP441 模块（国产芯片版本） |  |  | 淘宝商家（订单截图） |  |  |  |  |  |  |  |  | ¥4.0000 | ¥4.0000 |  |  |  |  |  |  |  | 用户订单截图 + 已提供采购价格 | 订单选项：INMP441 模块（国产芯片）/不焊接；数字 I2S，连接 MIC_SCK、MIC_DIN、MIC_WS；价格¥4/个。 | 模块型号已补 | 2026-11-01 | 用户2026-11-01麦克风订单截图
配套辅料 | FFC排线 | 连接主控板与灯板的30针排线 |  | 30Pin 0.5mm 100mm 异面 FFC 排线 |  | 1 |  | 30P / P0.5 / L100mm / 反向 | 30P 反向 0.5mm间距 100mm |  |  | 淘宝商家（订单截图） |  |  |  |  |  |  |  |  | ¥0.4200 | ¥0.4200 | 5 |  | 5 | ¥2.10 |  |  |  | 淘宝订单实付¥2.10/5条，平均¥0.42/条 | 30P反向、0.5mm间距、长100mm；5条装共¥2.10，单机1条成本¥0.42。 | 采购规格已补 | 2026-11-01 | 用户2026-11-01 FFC订单截图
3D打印件 | 结构/支撑 | 承托和定位组件 |  | 3D打印支撑板 |  | 1 |  | 半透明 PLA | 自制打印件 / 半透明 PLA |  |  |  |  |  |  |  |  |  |  |  | ¥3.5000 | ¥3.5000 |  |  |  |  |  |  |  | 用户提供实际打印材料成本 | 支撑板：半透明 PLA；每台1件，成本¥3.50。 STL/STEP和打印参数由结构文件提供。 | 材料与价格已补 | 2026-11-01 | 用户采购与打印记录
3D打印件 | 结构/底座 | 外壳底部结构 |  | 3D打印底座 |  | 1 |  | 丝绸银 PLA | 自制打印件 / 丝绸银 PLA |  |  |  |  |  |  |  |  |  |  |  | ¥1.4100 | ¥1.4100 |  |  |  |  |  |  |  | 用户提供实际打印材料成本 | 底座：丝绸银 PLA；每台1件，成本¥1.41。 STL/STEP和打印参数由结构文件提供。 | 材料与价格已补 | 2026-11-01 | 用户采购与打印记录
3D打印件 | 键帽/透明 | 六颗半透明键帽 |  | 3D打印透明键帽 |  | 6 |  | 半透明 PLA | 自制打印件 / 半透明 PLA |  |  |  |  |  |  |  |  |  |  |  | ¥0.1167 | ¥0.7000 | 6 |  | 6 | ¥0.70 |  |  |  | 用户提供实际打印材料成本 | 六颗透明键帽均使用半透明 PLA；6件合计¥0.70。 STL/STEP和打印参数由结构文件提供。 | 材料与价格已补 | 2026-11-01 | 用户采购与打印记录
3D打印件 | 键帽/黑色 | 一颗黑色键帽 |  | 3D打印黑色键帽 |  | 1 |  | 黑色 PLA | 自制打印件 / 黑色 PLA |  |  |  |  |  |  |  |  |  |  |  | ¥0.6000 | ¥0.6000 |  |  |  |  |  |  |  | 用户提供实际打印材料成本 | 黑色键帽使用黑色 PLA；每台1件，成本¥0.60。 STL/STEP和打印参数由结构文件提供。 | 材料与价格已补 | 2026-11-01 | 用户采购与打印记录
3D打印件 | 小型打印附件 | 旋钮帽、摇杆帽、拨动开关操作帽 |  | 3D打印小配件三件套 |  | 1 |  | 黑色 PLA | 自制打印件 / 黑色 PLA |  |  |  |  |  |  |  |  |  |  |  | ¥0.2000 | ¥0.2000 | 1 |  | 1 | ¥0.20 |  |  |  | 用户提供实际打印材料成本 | 旋钮帽、摇杆帽、拨动开关帽均用黑色 PLA，3件合计¥0.20。 STL/STEP和打印参数由结构文件提供。 | 材料与价格已补 | 2026-11-01 | 用户采购与打印记录

Sheet: 待补采购资料
序号 | 部件 / 主题 | 需提供的实际参数 | 为什么用于开源复刻 | 已有信息
1 | 电池 | 保护板持续电流/规格、极性与插头；商品链接 | 确认电源适配及采购 | 已提供：3.7V、850mAh、订单选项603443，¥8.50/个
2 | 热熔螺母 | 外径/长度和孔配合数据，商品链接 | 确保3D孔位与压入深度一致 | 已提供：M3×4×4.5，40个¥3.90，装8个
3 | M3 螺钉 | 可附安装位置和购买链接 | 确认头部、沉孔与装配余量 | 已提供：M3×6 内六角圆柱头，商品描述12.9级，50个¥2.60，装8个
4 | 音频模块 | 模块引脚顺序、供电和外形尺寸；商品链接 | 复刻模块接线与软件定义一致 | 已提供：INMP441（国产芯片、不焊接），¥4/个
5 | FFC 排线 | 商品链接、线缆厚度及装配照片（可选） | 采购同规格排线 | 已提供：30P反向、0.5mm、100mm，5条¥2.10；单台¥0.42
6 | 3D 打印件 | STL/STEP文件与打印参数；材料和颜色已明确 | 第三方使用同材料与零件数量打印 | 半透明PLA：支撑板+6透明键；丝绸银PLA：底座；黑色PLA：黑色键+3小配件
7 | 主控板 PCB | 板层、厚度、阻焊颜色、表面处理、Gerber/EDA文件版本 | 方便第三方直接打样 | ¥3.00/片
8 | 灯板 PCB | 板层、厚度、阻焊颜色、表面处理、Gerber/EDA文件版本 | 方便第三方直接打样 | ¥18.00/片
9 | 附加装配物料 | 其他键帽、橡胶垫、双面胶、导光件、装饰件是否存在及数量价格 | 避免开源 BOM 遗漏实际使用物料 | 当前只记已报价格的项
10 | 零件规格书链接 | 核心 IC 与连接器若有官方 datasheet URL，可补填完整BOM的规格书链接列 | 制造/替代核查更方便 | BOM已提供立创商品链接和厂家型号

Sheet: 开源说明
Codex Keyboard | 开源 BOM 使用说明
BOM 版本 | v0.96 / 2026-11-01
设计名称 | Codex Keyboard — ESP32-S3 USB/BLE 自制复刻键盘
主控板BOM来源 | BOM_CpuBoard2_CpuSchematic1_2026-10-23.xlsx
灯板BOM来源 | BOM_KeyBoard1_KeyboardSchematic1_2026-10-29.xlsx
主控板报价来源 | Codex_key_…CpuSchematic1_20261029_143657-立创_20261029.xls
灯板报价来源 | Codex_key_…KeyboardSchematic1_20261029_143747-立创_20261029.xls
报价采集日期 | 2026-10-29；供应商报价是历史价格，随时间和起订量变化
ESP32 主控单价 | 用户提供的淘宝实际采购价 ¥14.20，替代立创报价 ¥32.69
成本核算规则 | 仅按单台实际消耗数量×采用单价核算；FFC按¥2.10/5条分摊¥0.42/条；整包采购额另列
报价说明 | 立创报价单部分页面含整单优惠与额外库存信息；未将折扣分摊到单颗价格
器件检索 | 2026-11-01：补充电池 603443 容量850mAh；保留M3×4×4.5热熔螺母、M3×6螺钉、INMP441、30P反向FFC及PLA材料规格
电子BOM位号 | 3D打印：支撑板/透明键帽=半透明PLA；底座=丝绸银PLA；黑色键帽/小配件=黑色PLA
费用范围 | 不包含运费、焊接加工、贴片服务费、工具/失败损耗、其他未列入物料
制造与版权 | 开源发布前确定硬件/结构/固件许可证；原始 BOM 中的制造商商标和第三方资料仍各归其所有
更新方式 | 后续填写“待补采购资料”，并同步更新“完整BOM”中空白字段；不要猜测具体尺寸或型号
