doubleZ-dev/codex-keyboard/hardware/Codex_Micro_整机成本_含3D打印件_2026-10-29.xlsx

Sheet: 单机成本汇总
项目 | 成本(¥) | 依据 | 说明
主控板元件 | ¥22.23 | 立创报价明细 | 按实际使用数量 × 单价
灯板元件 | ¥45.60 | 立创报价明细 | 按实际使用数量 × 单价
两块 PCB | ¥21.00 | 用户提供 | 主控 3 元 + 灯板 18 元
额外物料 | ¥14.20 | 用户提供 | 电池、螺母、螺钉、音频、FFC
整机单机成本 | ¥103.02 | 合计 | 不含外壳、键帽、运费、贴片及损耗
3D 打印结构件 | ¥6.41 | 用户提供 | 支撑板、底座、6颗透明键、黑键、三件小配件
更新后整机单机成本 | ¥109.43 | 按实际使用数量 | 不含尚未列入的其他零件、运费及人工
核算口径 | 这里只计算一台实际消耗的元件，不将整包采购价当作单台成本
注意 | 立创报价存在起订量；此处仅计单机用量
核算口径 | 透明按键 ¥0.70 视为六颗合计

Sheet: 主控板元件
器件名称 | 位号 | 单机使用数量 | 报价单单价(¥) | 采购数量(MOQ) | 报价单采购小计(¥) | 单机用量成本(¥)
ESP32-S3-WROOM-1-N16R8 | U8 | 1 | 14.2000 | 1.0000 | 32.6900 | 14.2000
22uF | C21,C13,C12 | 3 | 0.2004 | 10.0000 | 2.0000 | 0.6012
100nF | C22,C25,C15,C14,C18,C19 | 6 | 0.0467 | 100.0000 | 4.6700 | 0.2802
ZX-QC34-2TPDZ | SW2,SW3 | 2 | 0.2023 | 10.0000 | 2.0200 | 0.4045
100kΩ | R20,R23 | 2 | 0.0064 | 100.0000 | 0.6400 | 0.0127
10kΩ | R2,R1 | 2 | 0.0142 | 100.0000 | 1.4200 | 0.0284
1uF | C7 | 1 | 0.0387 | 100.0000 | 3.8700 | 0.0387
FPC-05F-30PH20 | FPC2 | 1 | 0.8728 | 5.0000 | 4.3600 | 0.8728
SN74AHCT1G125DBVR | U1,U2 | 2 | 0.6131 | 5.0000 | 3.0700 | 1.2262
100nF | C1,C2 | 2 | 0.0490 | 50.0000 | 2.4500 | 0.0980
510Ω | R3 | 1 | 0.0091 | 100.0000 | 0.9100 | 0.0091
MT3608B | U3 | 1 | 0.6382 | 10.0000 | 6.3800 | 0.6382
110kΩ | R5 | 1 | 0.0113 | 100.0000 | 1.1300 | 0.0113
15kΩ | R7 | 1 | 0.0114 | 100.0000 | 1.1400 | 0.0114
4.7uH | L1 | 1 | 0.3755 | 10.0000 | 3.7600 | 0.3755
SS34 | D1,D3 | 2 | 0.1543 | 20.0000 | 3.0900 | 0.3086
AO3401A | Q1,Q2 | 2 | 0.1941 | 20.0000 | 3.8800 | 0.3882
10kΩ | R14,R13 | 2 | 0.0100 | 100.0000 | 1.0000 | 0.0199
5.1kΩ | R11,R10 | 2 | 0.0091 | 100.0000 | 0.9100 | 0.0182
TYPE-C16PIN | USB1 | 1 | 0.4010 | 10.0000 | 4.0100 | 0.4010
报价行 27 | - | 1 | 0.1030 | 10.0000 | 1.0300 | 0.1030
报价行 28 | - | 1 | 0.4690 | 10.0000 | 4.6900 | 0.4690
报价行 29 | - | 2 | 0.1290 | 20.0000 | 2.5800 | 0.2580
报价行 30 | - | 1 | 0.2425 | 20.0000 | 4.8500 | 0.2425
报价行 31 | - | 1 | 0.7300 | 5.0000 | 3.6500 | 0.7300
报价行 32 | - | 1 | 0.0076 | 100.0000 | 0.7600 | 0.0076
报价行 33 | - | 1 | 0.3800 | 10.0000 | 3.8000 | 0.3800
报价行 34 | - | 2 | 0.0095 | 100.0000 | 0.9500 | 0.0190
报价行 35 | - | 2 | 0.0372 | 50.0000 | 1.8600 | 0.0744

Sheet: 灯板元件
器件名称 | 位号 | 单机使用数量 | 报价单单价(¥) | 采购数量(MOQ) | 报价单采购小计(¥) | 单机用量成本(¥)
CPG151101D13 | U1,U4,U5,U7,U14,U15,U16,U17,U18,U19,U20,U21,U22 | 13 | 0.6242 | 15.0000 | 9.3600 | 8.1152
1N4148W-7-F | D1,D2,D3,D4,D5,D6,D7,D8,D9,D10,D11,D12,D13 | 13 | 0.1629 | 20.0000 | 3.2600 | 2.1177
SK6812MINI-E | LED1,LED2,LED3,LED4,LED5,LED6,LED7,LED8,LED9,LED10,LED11,LED12,LED13 | 13 | 0.4923 | 15.0000 | 7.3800 | 6.3999
100nF | C1,C2,C3,C4,C5,C6,C7,C8,C9,C10,C11,C12,C13 | 13 | 0.0490 | 50.0000 | 2.4500 | 0.6370
WS2812B-4020-V6 | U2,U3,U6,U8,U9,U10,U11,U12 | 8 | 0.6416 | 10.0000 | 6.4200 | 5.1328
10kΩ | VR1 | 1 | 7.3200 | 1.0000 | 7.3200 | 7.3200
EC11E18244A5 | SW1 | 1 | 14.7800 | 1.0000 | 14.7800 | 14.7800
XL-1005UWC | U13,U23,U24 | 3 | 0.0657 | 50.0000 | 3.2900 | 0.1972
1kΩ | R1,R5,R2 | 3 | 0.0077 | 100.0000 | 0.7700 | 0.0231
FPC-05F-30PH20 | FPC2 | 1 | 0.8728 | 5.0000 | 4.3600 | 0.8728

Sheet: 其他物料
其他成本项目 | 实际数量 | 单价(¥) | 单机成本(¥)
锂电池 | 1 | ¥8.50 | ¥8.50
热熔螺母 | 8 | ¥0.10 | ¥0.78
M3 螺丝 | 8 | ¥0.05 | ¥0.42
音频模块 | 1 | ¥4.00 | ¥4.00
FFC 排线 | 1 | ¥0.50 | ¥0.50
主控板 PCB | 1 | ¥3.00 | ¥3.00
灯板 PCB | 1 | ¥18.00 | ¥18.00
3D打印支撑板 | 1 | ¥3.50 | ¥3.50
3D打印底座 | 1 | ¥1.41 | ¥1.41
透明按键（6颗合计） | 1 | ¥0.70 | ¥0.70
黑色按键 | 1 | ¥0.60 | ¥0.60
旋钮帽+摇杆帽+拨动开关打印件（合计） | 1 | ¥0.20 | ¥0.20
3D打印件小计 |  |  | ¥6.41
其他物料含3D打印件合计 |  |  | ¥41.61
