doubleZ-dev/codex-keyboard/3d-print/BambuStudio_六个打印盘/OPENKEY_六盘总工程_槽宽1.20正式版.3mf

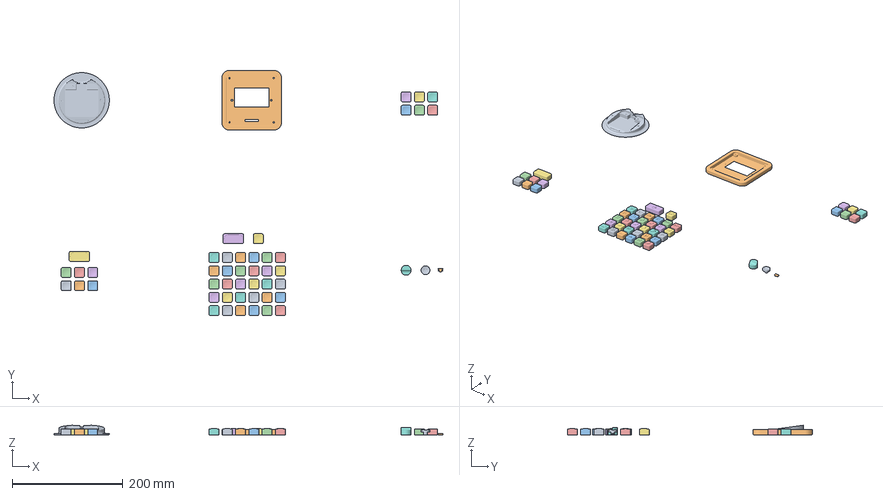
[picture p7: CAD file, 2026-10-30]
3d-print/BambuStudio_六个打印盘/OPENKEY_六盘总工程_槽宽1.20正式版.3mf
703.0 x 443.2 x 17.4 mm
底座
支撑板
透明键帽_1U x 6
纯黑键帽_1U x 6
纯黑键帽_长键
Pixel_01_agent
Pixel_02_ai-chip
Pixel_03_terminal
Pixel_04_download
Pixel_05_delete
Pixel_06_edit
Pixel_07_send
Pixel_08_spark
Pixel_09_new
Pixel_10_run
Pixel_11_history
Pixel_12_branch
Pixel_13_branch-plus
Pixel_14_sync
Pixel_15_clean
Pixel_16_experiment
Pixel_17_party
Pixel_18_clock
Pixel_19_think
Pixel_20_focus
Pixel_21_boost
Pixel_22_accept
Pixel_23_cancel
Pixel_24_split
Pixel_25_settings
Pixel_26_folder-plus
Pixel_27_upload
Pixel_28_apps
Pixel_29_yolo
Pixel_30_yeet
Pixel_31_voice-long
Pixel_32_chat-terminal
旋钮帽_编码器
摇杆帽
电源开关拨片
