doubleZ-dev/codex-keyboard/3d-print/BambuStudio_六个打印盘/03_六个透明键帽.3mf

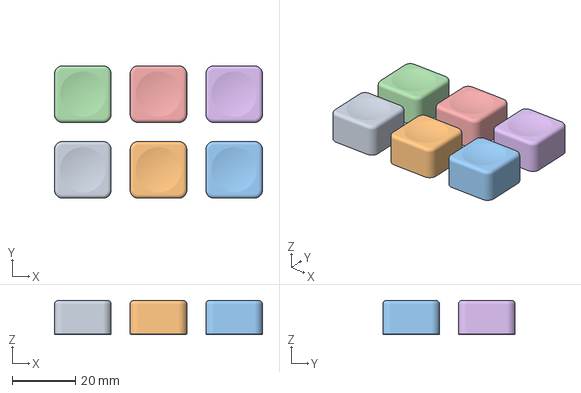
[picture p8: CAD file, 2026-10-30]
3d-print/BambuStudio_六个打印盘/03_六个透明键帽.3mf
66.0 x 42.0 x 10.8 mm
透明键帽_1U x 6
