doubleZ-dev/codex-keyboard/3d-print/BambuStudio_六个打印盘/01_底座.3mf

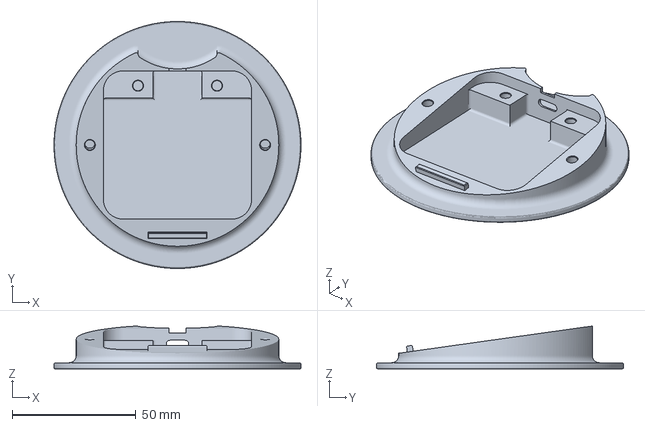
[picture p9: CAD file, 2026-10-30]
3d-print/BambuStudio_六个打印盘/01_底座.3mf
100.0 x 100.0 x 17.4 mm
