doubleZ-dev/codex-keyboard/3d-print/BambuStudio_六个打印盘/04_七个纯黑键帽.3mf

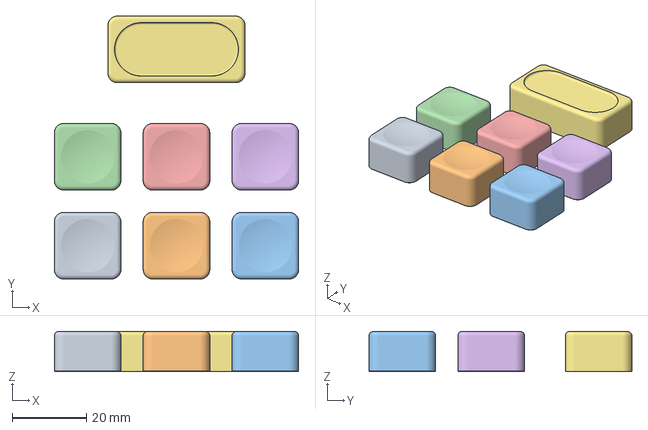
[picture p10: CAD file, 2026-10-30]
3d-print/BambuStudio_六个打印盘/04_七个纯黑键帽.3mf
66.0 x 71.0 x 10.8 mm
纯黑键帽_1U x 6
纯黑键帽_长键
