doubleZ-dev/codex-keyboard/3d-print/BambuStudio_六个打印盘/06_旋钮帽和摇杆帽.3mf

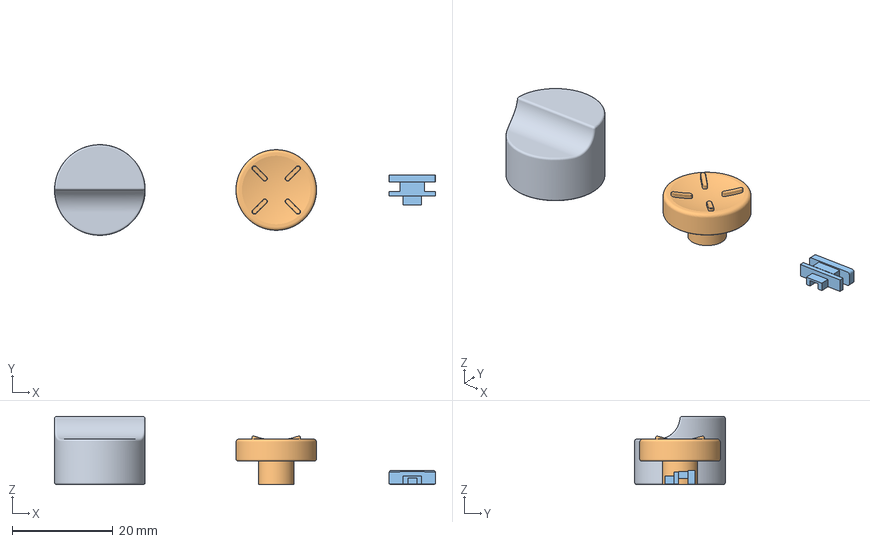
[picture p11: CAD file, 2026-10-30]
3d-print/BambuStudio_六个打印盘/06_旋钮帽和摇杆帽.3mf
75.6 x 18.0 x 13.5 mm
旋钮帽_编码器
摇杆帽
电源开关拨片
