doubleZ-dev/codex-keyboard/3d-print/BambuStudio_六个打印盘/02_支撑板.3mf

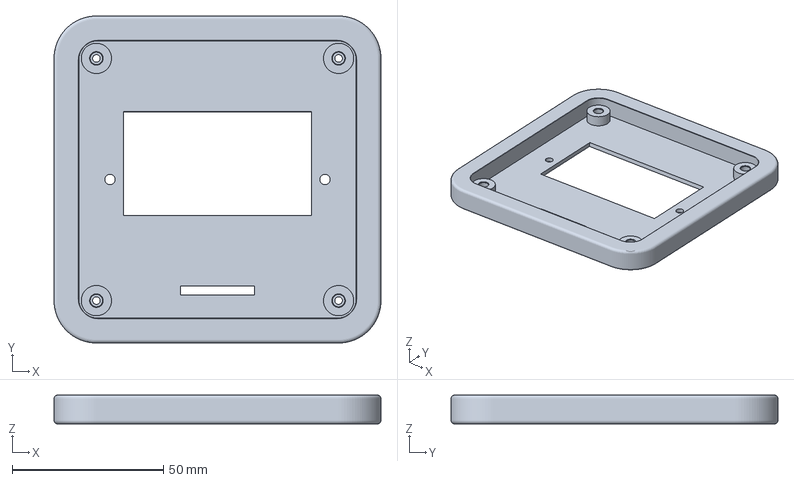
[picture p12: CAD file, 2026-10-30]
3d-print/BambuStudio_六个打印盘/02_支撑板.3mf
108.0 x 108.0 x 9.50 mm
