doubleZ-dev/codex-keyboard/docs/video-guide.md

# 视频导览与图片来源

[返回项目首页](../README.md) · [图文制作教程](assembly.md) · [使用说明](usage.md)

**[观看完整视频：我逆向复刻了 Codex 键盘，成本只要…（哔哩哔哩）](https://b23.tv/TivtklJ)**

本文档与配图来自作者提供的完整视频 `V2_final_2K.mp4`，约 **6 分 01 秒**，原始画面 **2560×1440 / 30 fps**，并结合对应文案与现有固件资料整理。原始大视频未提交到仓库。

## 章节索引

时间是原始成片中的大致位置。成片包含转场与插入画面，图文教程按实际制作顺序重新组织。

| 时间 | 内容 |
| --- | --- |
| 00:00 | 项目与成品介绍、成本、主要功能 |
| 00:36 | 硬件设计、原理图、PCB、焊接与电气检查 |
| 01:58 | 结构设计、材料、打印与图案键帽 |
| 03:05 | 热熔螺母、主控板、电池、支撑板与按键装配 |
| 03:41 | Agent 键、状态灯、语音、旋钮、摇杆与 Input |
| 04:55 | 项目创作过程与总结 |

## 已采用的截图

JPEG 图片从视频直接抽取，裁去底部章节条，多数同时裁去硬编码字幕区域，再缩放至 1600 像素宽。个别装配总览保留更高的画面以展示零件。未生成替代实物的合成画面。截图中的制作过程或旧结构不作为所有版本尺寸一致的证明。

| 时间 | 图片 | 用途 |
| --- | --- | --- |
| 03:53.0 | [成品主图](images/hero.jpg) | 成品主图 |
| 00:08.0 | [正面近景](images/front.jpg) | 正面近景 |
| 00:37.5 | [视频中的结构分解展示](images/exploded.jpg) | 视频中的结构分解展示 |
| 03:00.2 | [主要零件总览](images/parts.jpg) | 主要零件总览 |
| 01:21.7 | [主控板贴装](images/solder-power.jpg) | 主控板贴装 |
| 01:33.0 | [主控板元件面](images/mainboard.jpg) | 主控板元件面 |
| 01:43.4 | [按键/灯板](images/keyboard-pcb.jpg) | 按键/灯板 |
| 01:48.0 | [万用表检查](images/continuity.jpg) | 万用表检查 |
| 01:56.4 | [封壳前亮灯测试](images/first-light.jpg) | 封壳前亮灯测试 |
| 02:52.0 | [图案键帽](images/printed-keycaps.jpg) | 图案键帽 |
| 03:07.7 | [底座热熔螺母](images/heat-inserts.jpg) | 底座热熔螺母 |
| 03:17.0 | [支撑板热熔螺母](images/support-inserts.jpg) | 支撑板热熔螺母 |
| 03:21.5 | [主控板与电池](images/mainboard-battery.jpg) | 主控板与电池 |
| 03:25.2 | [支撑板固定](images/support-install.jpg) | 支撑板固定 |
| 03:28.0 | [安装按键板](images/keyboard-install.jpg) | 安装按键板 |
| 03:33.5 | [安装键帽](images/keycaps-install.jpg) | 安装键帽 |
| 03:38.0 | [装配成品](images/assembled.jpg) | 装配成品 |
| 04:09.3 | [灯光展示](images/agent-demo.jpg) | 灯光展示 |

`controls.svg` 为根据实物布局和当前固件说明绘制的功能示意；`cost-breakdown.svg` 根据 BOM v0.96 数据生成。两者是说明图，不是实物照片或制造图。

## 如何理解演示证据

视频展示的操作用于解释制作方法与使用流程。状态灯展示中包含人为演示，不能据颜色判断实际 Agent 任务状态。对于当前固件行为，以[使用说明的差异与限制](usage.md#当前版本的差异与限制)及包内版本记录为准。
