doubleZ-dev/codex-keyboard/CHANGELOG.md

# 更新记录

## 2026-11-02 · 项目文档完善

- 扩充项目首页，加入成品、主要功能、硬件组成、成本表、制作路径和下载导航。
- 从作者提供的视频提取 18 张实物/结构/装配画面，加入时间索引。
- 增加控件示意图、成本图，以及打印、硬件、制作、刷写、使用和开发说明。
- 加入原始 BOM v0.96，当前已列物料参考合计 ¥109.35，黑色键帽按作者确认的整套价格解释。
- 加入作者 B 站视频链接、主控板两层与灯板四层的打样信息。
- 核对五个总工程文件为相同内容，明确一个推荐入口。
- 固件仍为 1.0.0-rc.7，本次文档更新没有执行设备烧录或新增实机验收。
