doubleZ-dev/codex-keyboard/(list of files, drawings)

Other design files:
hardware/ProPrj_Codex_key_2026-10-20_10-08-15_2026-11-04.epro
