doubleZ-dev/codex-keyboard/(commit log)

2026-10-30 Add Codex Keyboard hardware, print files, and current firmware
    [01_底座.3mf, 02_支撑板.3mf, 03_六个透明键帽.3mf, 04_七个纯黑键帽.3mf, 05_三十二个图案键帽.3mf, 06_旋钮帽和摇杆帽.3mf, Codex_Micro_整机成本_含3D打印件_2026-10-29.xlsx, OPENKEY_六盘总工程.3mf]
2026-11-02 Expand project guides with build video frames and BOM v0.96
    [Codex_Keyboard_开源BOM_v0.96.xlsx]
2026-11-04 Update hardware archive to 2026-11-04
    [ProPrj_Codex_key_2026-10-20_10-08-15_2026-10-22.epro, ProPrj_Codex_key_2026-10-20_10-08-15_2026-11-04.epro]
